dakshb2/stair-climbing-robot/(list of files, cad)

Other CAD files:
cad/phase1/frame/frame_leg.f3d
cad/phase1/frame/frame_plate_crank_side.f3d
cad/phase1/frame/frame_plate_non_crank_side.f3d
cad/phase1/frame/frame_top_plate.f3d
cad/phase1/hardware/barrel_fastener_25mm.f3d
cad/phase1/hardware/barrel_fastener_30mm.f3d
cad/phase1/hardware/screws.f3d
cad/phase1/hardware/spacer_1p5mm.f3d
cad/phase1/hardware/spacer_barrel_fastener.f3d
cad/phase1/hardware/spacer_crank.f3d
cad/phase1/hardware/spacer_square_rod_4mm.f3d
cad/phase1/hardware/spacer_square_rod_8mm.f3d
cad/phase1/linkage/coupler_leg.f3d
cad/phase1/linkage/crank_inner.f3d
cad/phase1/linkage/crank_inner_connector.f3d
cad/phase1/linkage/crank_outer.f3d
cad/phase1/linkage/crank_outer_handle_side.f3d
cad/phase1/linkage/handle.f3d
cad/phase1/linkage/rocker.f3d
