dakshb2/stair-climbing-robot/(commit log)

2026-10-11 Phase 1: two-legged four-bar walking mechanism
    [1.5mm spacer.f3d, Crank.f3d, Orange Link Crank Side.f3d, Simple Frame Leg.f3d, Simple frame crank side.f3d, Simple frame non crank side.f3d, Simple frame top part.f3d, Spacer_Crank (1 needed).f3d]
2026-10-11 Organise files into phase folders
    [1.5mm spacer.f3d, Crank.f3d, Orange Link Crank Side.f3d, Simple Frame Leg.f3d, Simple frame crank side.f3d, Simple frame non crank side.f3d, Simple frame top part.f3d, Spacer_Crank (1 needed).f3d]
2026-10-11 Standardise file names and organise into subfolders
    [barrel_fastener_25mm.f3d, barrel_fastener_30mm.f3d, coupler_leg.f3d, crank_inner.f3d, crank_inner_connector.f3d, crank_outer.f3d, crank_outer_handle_side.f3d, frame_leg.f3d]
2026-10-11 Add video link to README
    Added a video link demonstrating the prototype.
